wagiminator/ATtiny85-TinyLoad/hardware/TinyLoad_BOM_v1.0.tsv

ID | Name | Designator | Footprint | Quantity | Manufacturer Part | Manufacturer | Supplier | Supplier Part
1 | 1N4148W | D3 | DIODE-SOD-123 | 1 | 1N4148W-E3-08 | Vishay Intertech | LCSC | C241939
2 | SI2302 | Q2 | SOT-23_L2.9-W1.3-P0.95-LS2.4-BR | 1 | SI2302 | Bourne Semicon (Shenzhen) | LCSC | C344009
3 | KF301-2P | TEST | KF301-2P | 1 | KF301R-5.0-2P | Cixi Kefa Elec | LCSC | C474883
4 | LMV358 | U3 | SOP-8_150MIL | 1 | LMV358IDR | TI | LCSC | C63813
5 | OLED | OLED1 | I2C OLED 0.96&AMP;QUOT; 128X64 | 1 | SSD1306 I2C OLED
6 | 5V1 | D2 | ZENER-SOD-123 | 1 | MMSZ4689 | ON Semicon | LCSC | C184214
7 | 100k | R8,R7 | 603 | 2 | 0603WAF1003T5E | UniOhm | LCSC | C25803
8 | 10k | R12,R1 | 603 | 2 | 0603WAF1002T5E | UniOhm | LCSC | C25804
9 | 1k | R13 | 603 | 1 | 0603WAF1001T5E | UniOhm | LCSC | C21190
10 | 10k | R11,R9,R2 | 603 | 3 | 0603WAF1002T5E | UniOhm | LCSC | C25804
11 | 47k | R10 | 603 | 1 | 0603WAF4702T5E | UniOhm | LCSC | C25819
12 | IRL540NPBF | Q1 | TO-220-3_L10.0-W4.5-P2.54-T | 1 | IRL540NPBF | Infineon | LCSC | C111607
13 | 5A | F1 | F1206 | 1 | 12H1500D | Shenzhen lanson Elec | LCSC | C182446
14 | ATtiny85 | U1 | SOIC-8_208MIL | 1 | ATTINY85-20SU | MICROCHIP | LCSC | C89852
15 | USB PWR Connector | USB | USB PWR CONNECTOR | 1 | KH-MICRO-SMT.J-2P | Shenzhen Kinghelm Elec | LCSC | C2688799
16 | 1u | C3 | 603 | 1 | CL10A105KB8NNNC | SAMSUNG | LCSC | C15849
17 | ICSP-6 | ICSP | ICSP-6 | 1 | C65114 | BOOMELE | LCSC | C65114
18 | 3x6x2.5 | RESET,SET | KEY-3.0*6.0 | 2 | 3x6x2.5Red head high temperature | ReliaPro | LCSC | C46491
19 | 100n | C5,C1,C6,C4 | 603 | 4 | CC0603KRX7R9BB104 | YAGEO | LCSC | C14663
20 | 47u | C2 | 1206 | 1 | 1206F476M160NT | FH | LCSC | C30300
21 | 10k | R6 | RES-ADJ-TH_3296X-8MM | 1 | 3296X-1-103 | Chengdu Guosheng Tech | LCSC | C330445
22 | Header | FAN,NTC | HEADER_2X1 | 2 | 826629-2 | TE Connectivity | LCSC | C86471
23 | R300 | R3,R4,R5 | 2512 | 3 | CR2512F0R3E04 | Ever Ohms Tech | LCSC | C176052
24 | SS54 | D1 | DIODE-SMA(DO-214AC) | 1 | SS54 | Jingdao | LCSC | C123946
