wagiminator/ATtiny85-TinyLoad/hardware/TinyLoad_schematic_v1.0.pdf

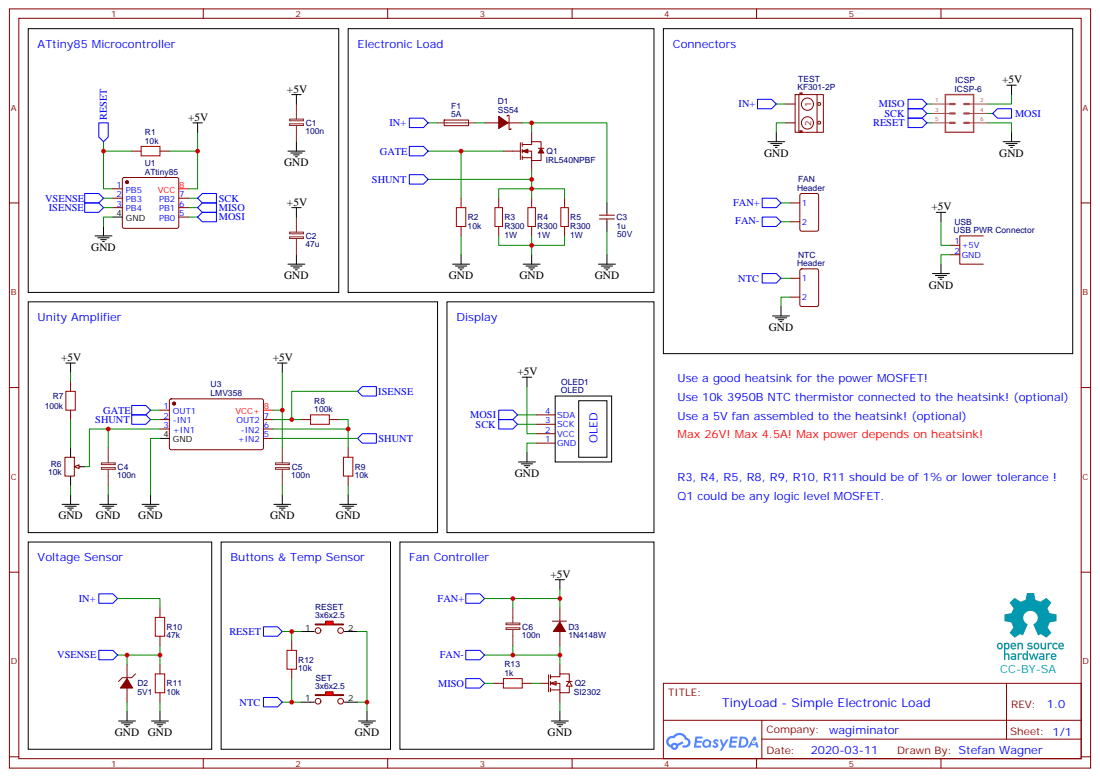
[picture p5: page 1]

Use a good heatsink for the power MOSFET!
Use 10k 3950B NTC thermistor connected to the heatsink! (optional)
Use a 5V fan assembled to the heatsink! (optional)
Max 26V! Max 4.5A! Max power depends on heatsink!

R3, R4, R5, R8, R9, R10, R11 should be of 1% or lower tolerance !
Q1 could be any logic level MOSFET.

Drawn By: Stefan Wagner
