wagiminator/ATtiny85-TinyLoad/(threads)

Thread 1 (2023-06-13):

ask

anwfeb, 2023-06-13:
Hi,
I have tried to make the ATtiny85-TinyLoad project but I see there is a difference, if I turn the potentiometer to the left (closed) 0% then the OLED display is 0.62A. I am using R_Shunt 0.01ohm with value ICONV 7201920 and ILCAL 0.72, when I rotate potentiometer for 1.00A or 1.50A or 2.00A I get appropriate load value (with Digital Clamp Meter) , only if I rotate potentiometer 0% I can't get 0.00A on OLED screen and get display screen 0.62A, can you help me ?

Thank you.

wagiminator, 2023-06-13:
Hi, you will never reach 0V. This is due to the limitations of the OpAmp (input offset voltage and minimum output voltage). You can get closer to 0V by either choosing a larger shunt resistor or a better OpAmp.

wagiminator, 2023-06-13:
With the cheap OpAmps there is a greater scatter in terms of their parameters. The pin-compatible OPA2333 is a good choice, but you seem to have had success with the generic LMV358, so keep it!

anwfeb, 2023-06-13:
yes after i tested 10 lmv358 generic now i have 3 chips working fine. and I also added an LC Filter before the input voltage, because my power supply is not very good it makes the resistance on the display screen always change.

I'm still hoping for some sort of calibration to set the potentiometer at 0% by getting a 0.00A screen display using my original old chip, if possible.

anwfeb, 2023-07-05:
Hi, thank you.
now i will say all the precision when i replace with OPA2333A original parts, i have bought and tried, from 10mA to 5 Ampere i tested and the result is very precision, thank you good project and very useful.
