wagiminator/ATtiny85-TinyLoad/(commit log)

2020-11-18 Update files
    [TinyLoad_BOM_v1.0.tsv]
2022-09-10 Update BOM
    [TinyLoad_BOM_v1.0.tsv]
